gom9000/floppyti/resources/floppyti_built_inside2.jpeg

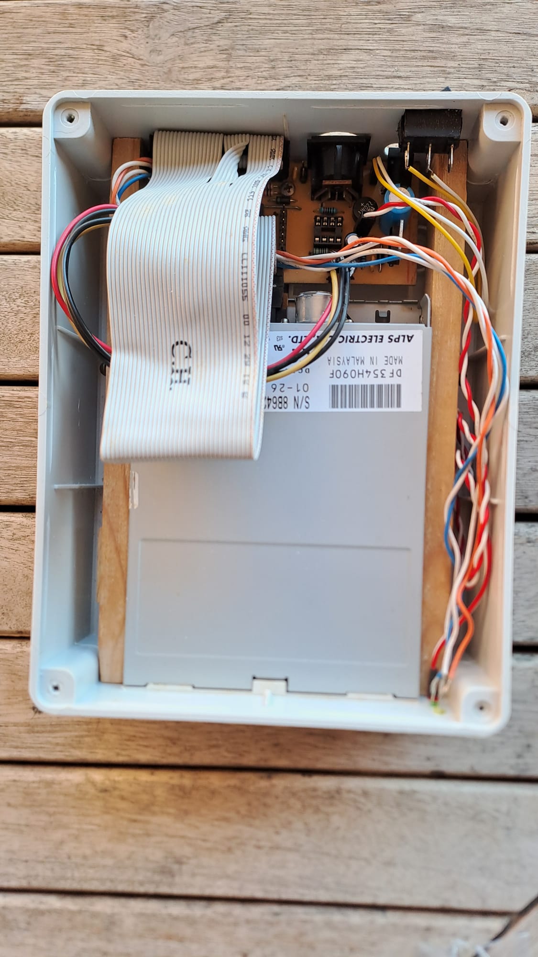
resources/floppyti_built_inside2.jpeg
