gom9000/floppyti/(list of files, drawings)

Other design files:
hardware/floppyti.pcb
