gom9000/floppyti/(commit log)

2017-03-09 Added Floppyti project v1.0
    [floppyti.pcb, floppyti.sch, floppyti2.sch]
2026-08-07 refresh repo
    [floppyti2.sch]
